MaurycyManski/Charakterystyki-diod/README.md

# Charakterystyki-diod
Stworzono system rysujący charakterystyki realnych diod

Link do filmu prezentującego działanie systemu:

https://drive.google.com/drive/folders/1EEKfAYPRC0WlMcC9hQY4KBUkUX3pppZl?usp=sharing
