MaurycyManski/Charakterystyki-diod/UKLAD_DO_POMIARU_DIOD.pdf

Maurycy Mański 165179

# Oprogramowanie systemów elektronicznych – projekt

### „Charakterograf do wyznaczania charakterystyk diod”

### 1. Założenia projektowe

Założeniem projektowym było stworzenie systemu elektronicznego, który miałby komunikować się z komputerem ogólnego przeznaczenia (dalej PC) w celu wysłania informacji, a następnie przetworzenie ich po stronie PC. Wybrano temat: „Charakterograf do wyznaczania charakterystyk diod”. Zadaniem tego systemu jest wykonywanie pomiarów w celu uzyskania charakterystyk prądowo-napięciowych diod.

### 2. Zadania do wykonania

(1) Zaprojektować układ pomiarowy
(2) Wybrać mikrokontroler (dalej MCU)
(3) Wybrać interfejs pomiędzy MCU a PC
(4) Zaimplementować fizycznie układ
(5) Stworzyć algorytm po stronie MCU
(6) Stworzyć algorytm i graficzny interfejs użytkownika (dalej GUI) po stronie PC
(7) Przetestować działanie systemu

### 3. Realizacja

a. Układ pomiarowy

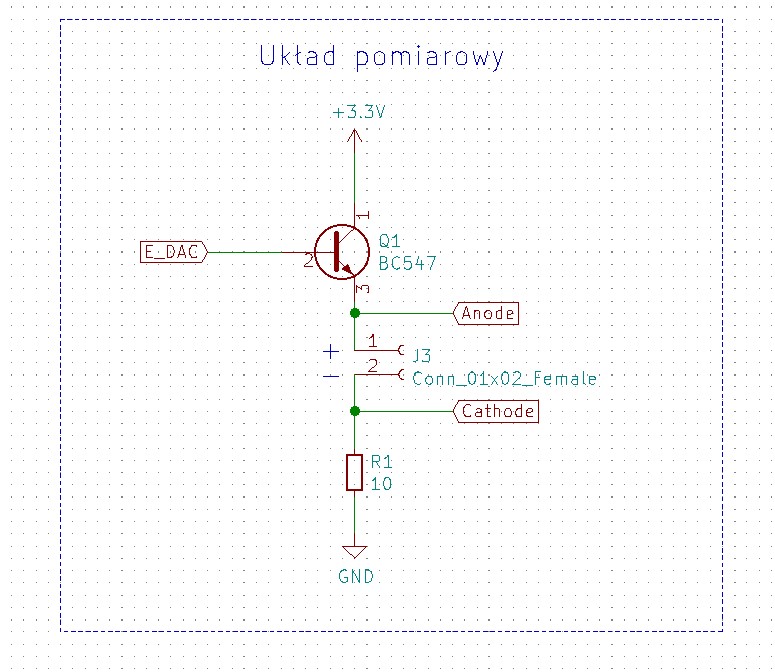
[picture p1: figure]

Układ pomiarowy składa się z:

- przetwornika cyfrowo-analogowego (dalej DAC)
- 2 przetworników analogo-cyfrowych (dalej ADC)
- tranzystora bipolarnego
- rezystora

DAC polaryzuję badaną diodę tworząc 2n
punktów pracy, gdzie n jest liczbą bitów w DACu. Aby nie obciążać DACa, jak również zwiększyć jego maksymalny wyjściowy prąd zastosowano tranzystor bipolarny który będzie wymuszał spadek napięcia 0.7V. Fakt ten sprawia że napięcie ustawiane E_DAC powinno wynosić przynajmniej 0.7V aby utrzymać tranzystor w stanie przewodzenia. Rezystor pełni funkcję „czujnika prądu”.

Przy doborze tranzystora zwracano uwagę, aby Icmax był co najmniej 100mA a wzmocnienie β jak największe. Zgodnie z wymaganiami wybrano tranzystor bc547b. Natomiast rezystor dobrano tak aby miał niewielką wartość aby nie ograniczał prądu diody i był metalizowany, żeby nie wprowadzał dodatkowych szumów do układu. Przetworniki ADC i DAC są wbudowanymi peryferiami w wybrany MCU.

b. Wybór MCU

Początkowo rozważano wybór płytki rozwojowej Arduino Uno jako jednostkę wykonawczą w systemie. Jednak niska rozdzielczość ADC wynosząca 10bitów i brak DACa wymuszałaby wprowadzenie oddzielnie tych peryferiów do układu. Dlatego wybór platformy padł na NUCLEO-64L476RG. Moduł ten oferuje ADC o rozdzielczości 12bitów jak również DACa o tej samej rozdzielczości 12bitów. Dzięki takiej rozdzielczości możliwe jest uzyskanie 4096 (2¹²) punktów pracy z szumem kwantyzacji na poziomie 0.8mV (3.3V/2¹²). Również dużą zaletą NUCLEO jest możliwość wysokopoziomowego podejścia dzięki bibliotece HAL (ang. hardware abstraction layer).

c. Interfejs pomiędzy MCU a PC

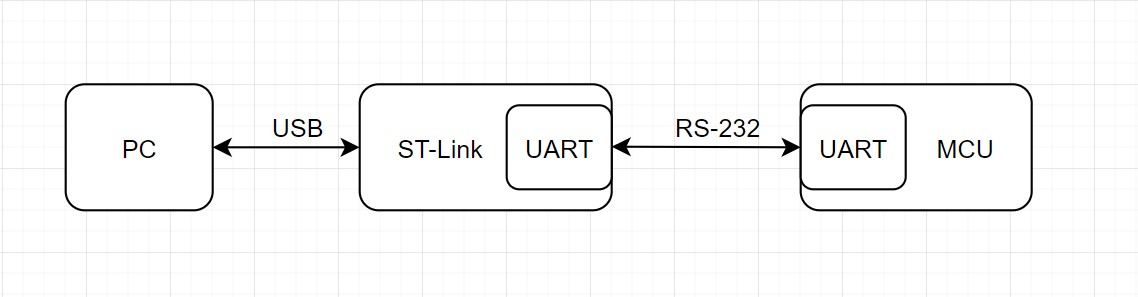
[picture p2: figure]

MCU komunikuje się z ST-Linkiem przez interfejs RS-232 za pomocą modułów UART. Następnie ST-Link komunikuje się z PC poprzez interfejs USB. ST-Link jest widoczny w PC jako wirtualny COM-Port.

d. Fizyczna implementacja układu

W celu zwiększenia dokładności pomiaru i pewności połączeń elektrycznych zrezygnowano z płytki stykowej i przewodów wpinanych typu pin-header. Wykonano prostą nakładkę na moduł NUCLEO w formie wpinanej płytki rozszerzającej (w formie shielda). Poniżej zrzut ekranu z programu KiCad:

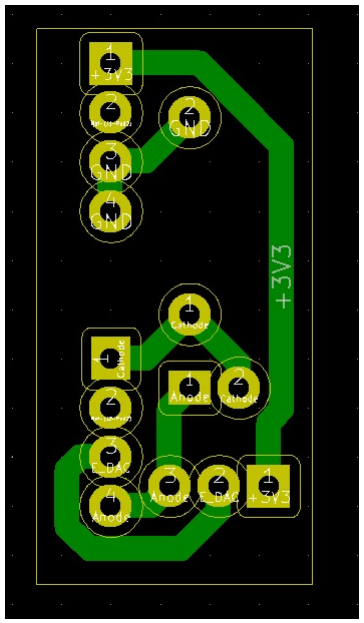
[picture p3: figure]

Płytkę wykonano fizycznie metodą termo transferu.

e. Algorytm po stronie

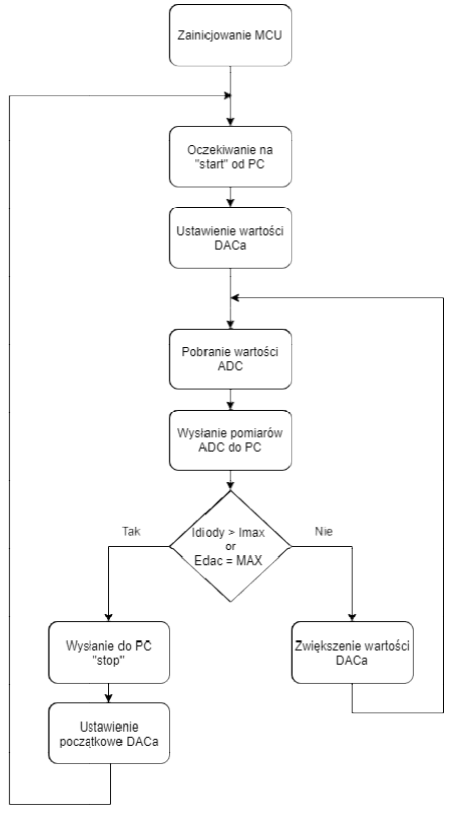
[picture p4: figure]

Algorytm w MCU został zaimplementowany za pomocą na sygnał start od PC zapalony
gotowości do zbadania kolejnego

MCU

został zaimplementowany za pomocą języka C. Podczas ocze jest zielony LED na płytce NUCLEO w celu sygnalizacji elementu.

Podczas oczekiwania

f. Algorytm i GUI

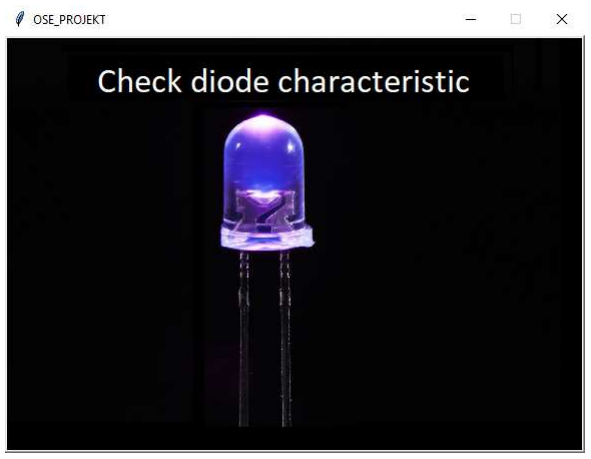
[picture p5: figure]
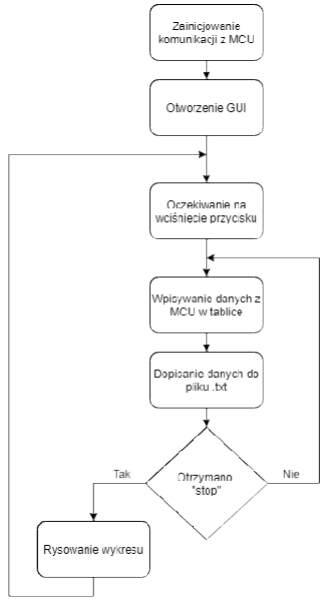
[picture p6: figure]

Algorytm i GUI po stronie PC
ma minimalistyczną formę okna o stałej
MCU sygnał „start”. Zapisywanie danych do pliku .txt jest dodatkową funkcjonalnością

po stronie PC

zostały napisane w języku Python. Interfejs użytkownika formę okna o stałej wielkości z jednym przyciskiem
Zapisywanie danych do pliku .txt jest dodatkową funkcjonalnością

Interfejs użytkownika
wysyłającym do

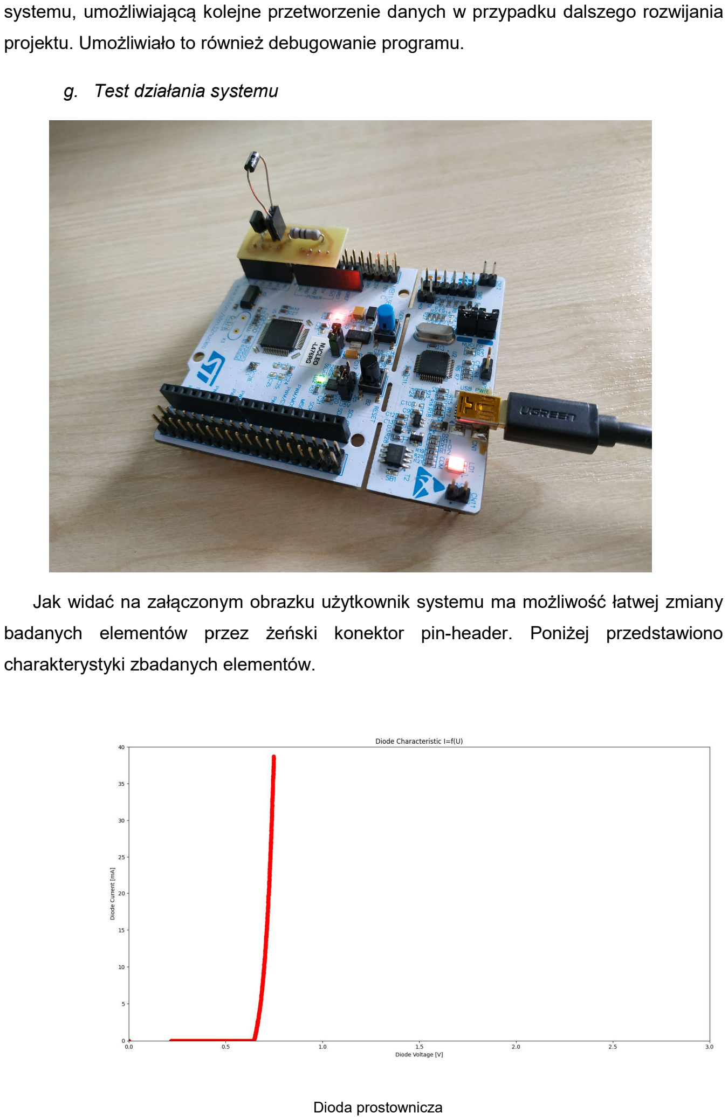
[picture p7: page 7]

systemu, umożliwiającą kolejne projektu. Umożliwiało to również debug

g. Test działania systemu

Jak widać na załączonym obrazku użytkownik sys badanych elementów przez żeński konektor charakterystyki zbadanych elementów.

kolejne przetworzenie danych w przypadku dalszego rozwijania owanie programu.

temu ma możliwość łatwej zmiany ntów przez żeński konektor pin-header. Poniżej przedstaw

Dioda prostownicza

oniżej przedstawiono

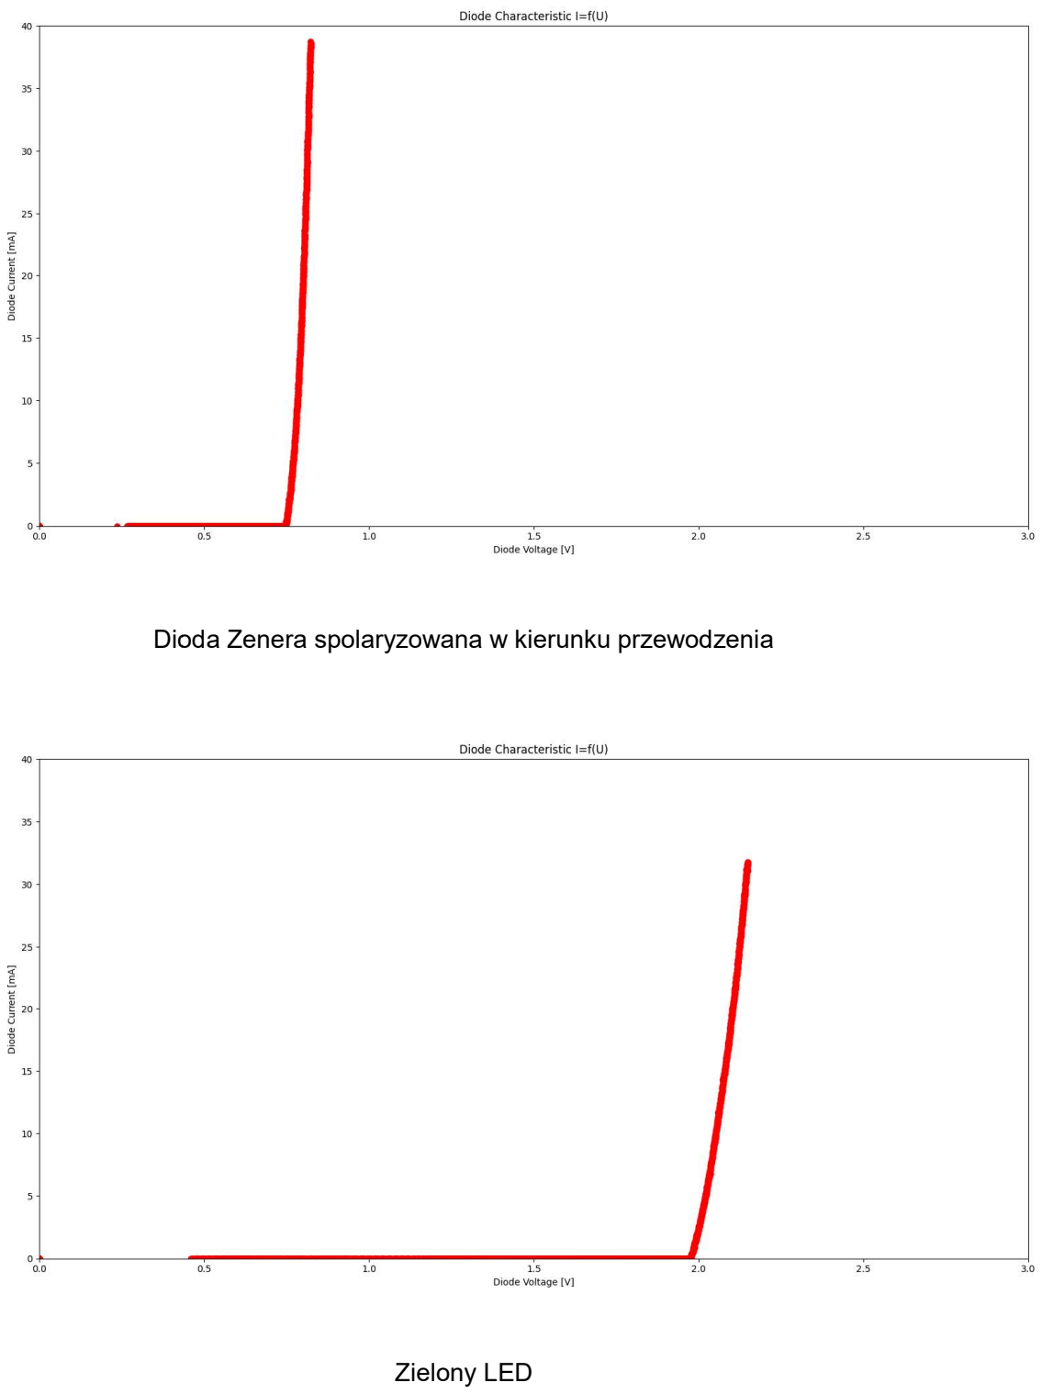
[picture p8: page 8]

Dioda Zenera spolaryzowana w kierunku przewodzenia

Zielony LED

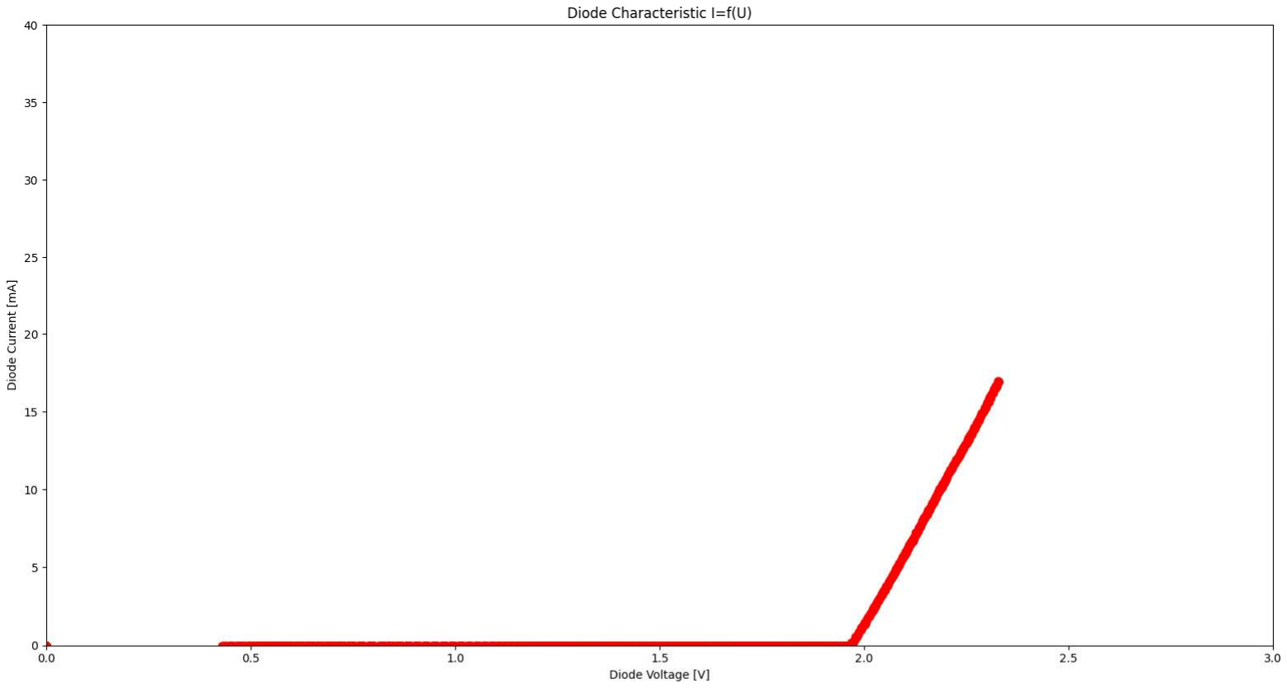
[picture p9: figure]

Założenia projektowe zostały spełnione a układ diod. Odczytane z wykresów
z pomiarami wykonanymi multimetrem
liczbę elementów możliwych do zbadania. W przykładowo zbadanie niebieskich
ponieważ ich spadki napięcia są większe od zasilania układu.

Czerwony LED

poprawnie wykreśla charakterystyki wartości spadków napięć pokrywają
. Jednak napięcie zasilania MCU zbudowanym systemie
ledów lub diody Zenera spolaryzowa

się w przybliżeniu
(3.3V) ogranicza
nie jest możliwe
nej zaporowo,
