MaurycyManski/Charakterystyki-diod/ADC/Src/main.c

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

/* Includes ------------------------------------------------------------------*/
#include "main.h"

/* USER CODE BEGIN Includes */
#include <stdio.h>
#include <string.h>
/* USER CODE END Includes */

/* USER CODE BEGIN PM */
#define Imax 40
/* USER CODE END PM */

ADC_HandleTypeDef hadc1;
ADC_HandleTypeDef hadc2;

DAC_HandleTypeDef hdac1;

UART_HandleTypeDef huart2;

void SystemClock_Config(void);
static void MX_GPIO_Init(void);
static void MX_ADC1_Init(void);
static void MX_ADC2_Init(void);
static void MX_DAC1_Init(void);
static void MX_USART2_UART_Init(void);
/**
  * @brief  The application entry point.
  * @retval int
  */
int main(void)
{
  

  /* MCU Configuration--------------------------------------------------------*/

  /* Reset of all peripherals, Initializes the Flash interface and the Systick. */
  HAL_Init();

  /* USER CODE BEGIN Init */
  char textToWrite[12];
void clearBuffer(){
	for(int i=0; i<12; i++){
		textToWrite[i] = "";
	}

}
  /* USER CODE END Init */

  /* Configure the system clock */
  SystemClock_Config();

  /* Initialize all configured peripherals */
  MX_GPIO_Init();
  MX_ADC1_Init();
  MX_ADC2_Init();
  MX_DAC1_Init();
  MX_USART2_UART_Init();
  /* USER CODE BEGIN 2 */
  uint8_t len;
  uint8_t start=0;
  uint16_t dac_value = 870;//about 0.7V
  uint16_t adc[2];
  HAL_GPIO_WritePin(LD2_GPIO_Port, LD2_Pin, GPIO_PIN_SET);
  /* USER CODE END 2 */

  /* Infinite loop */
  /* USER CODE BEGIN WHILE */
  while (1)
  {
	  //waiting for 'S' to send PC -> MCU at the beginning
	  while(start!=83) HAL_UART_Receive(&huart2,&start,1,HAL_MAX_DELAY);

	  //setting value on DAC and ON LED as visual pointer
	  HAL_GPIO_WritePin(LD2_GPIO_Port, LD2_Pin, GPIO_PIN_RESET);
	  HAL_DAC_Start(&hdac1, DAC_CHANNEL_1);
	  while(1){
	  HAL_DAC_SetValue(&hdac1, DAC1_CHANNEL_1, DAC_ALIGN_12B_R, dac_value);
	  //HAL_Delay(50);

	  //taking samples from ADC
	  HAL_ADC_Start(&hadc1);
	  HAL_ADC_Start(&hadc2);
	  HAL_ADC_PollForConversion(&hadc1,1000);
	  HAL_ADC_PollForConversion(&hadc2,1000);
	  adc[0] = HAL_ADC_GetValue(&hadc1);
	  adc[1] = HAL_ADC_GetValue(&hadc2);

	  //sending data through UART to PC
	  clearBuffer();
	  len = sprintf(textToWrite, "%u\n", adc[0]);
	  HAL_UART_Transmit(&huart2, textToWrite, len,1000);
	  clearBuffer();
	  len = sprintf(textToWrite, "%u\n", adc[1]);
	  HAL_UART_Transmit(&huart2, textToWrite, len,1000);

	  //if diode reach current limit or max DAC value -> stop incrementing DAC
	  if((adc[0] > (Imax*12)) || (dac_value == 4095))break;
	  dac_value++;
	  }
	  //turn off ADC, DAC, setting default variable value
	  HAL_DAC_Stop(&hdac1, DAC_CHANNEL_1);
	  HAL_ADC_Stop(&hadc1);
	  HAL_ADC_Stop(&hadc2);
	  dac_value = 870;
	  start=0;
	  //sending stop to show end of transmission
	  clearBuffer();
	  len = sprintf(textToWrite,"stop");
	  HAL_UART_Transmit(&huart2, textToWrite, len, 1000);
	  HAL_GPIO_WritePin(LD2_GPIO_Port, LD2_Pin, GPIO_PIN_SET);

    /* USER CODE END WHILE */

    /* USER CODE BEGIN 3 */
  }
  /* USER CODE END 3 */
}

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
